Rr42/LED-display-8x11/Hardware/LED-display/LED-display-raytraced-2.png

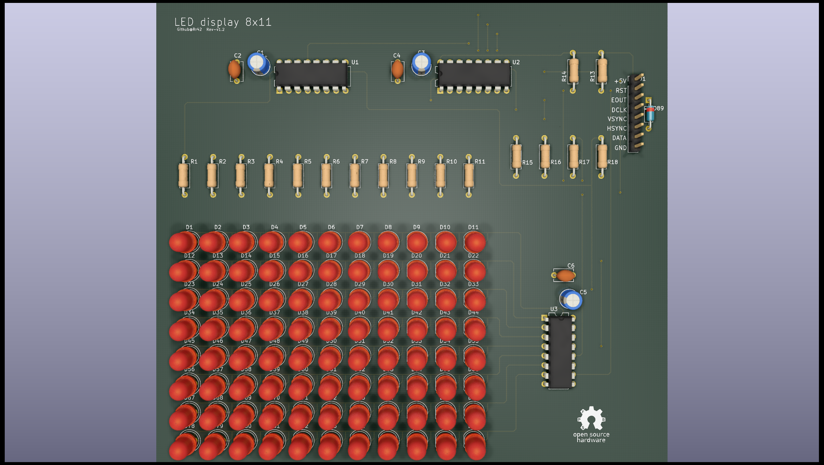
Hardware/LED-display/LED-display-raytraced-2.png
