Rr42/LED-display-8x11/Hardware/LED-display/LED-display.png

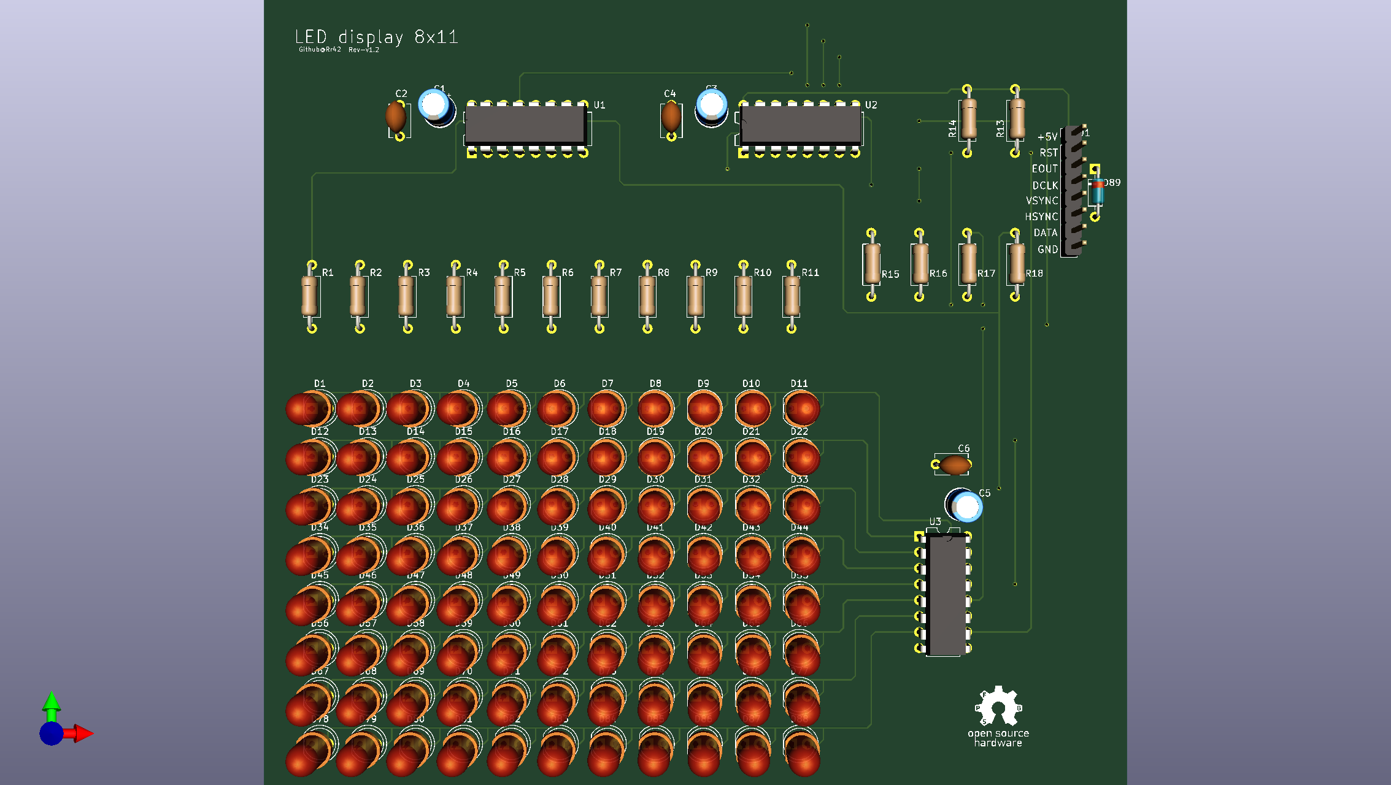
Hardware/LED-display/LED-display.png
