Rr42/LED-display-8x11/LED-display-fab-assimbled.jpg

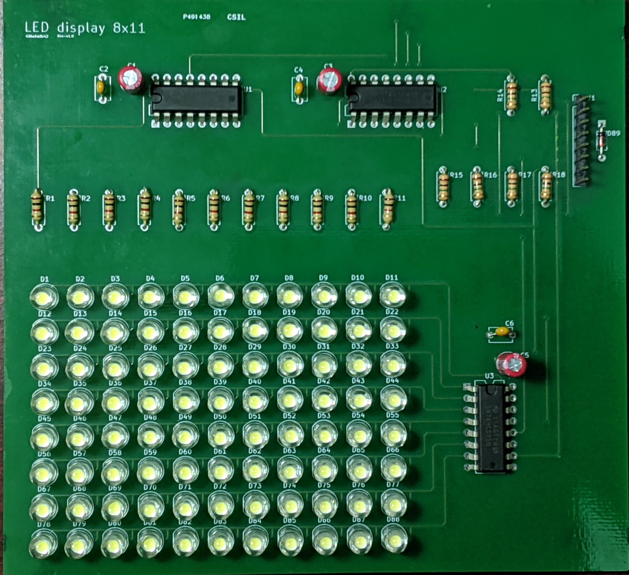
LED-display-fab-assimbled.jpg
