Rr42/LED-display-8x11/LED-display-pattern-1.jpg

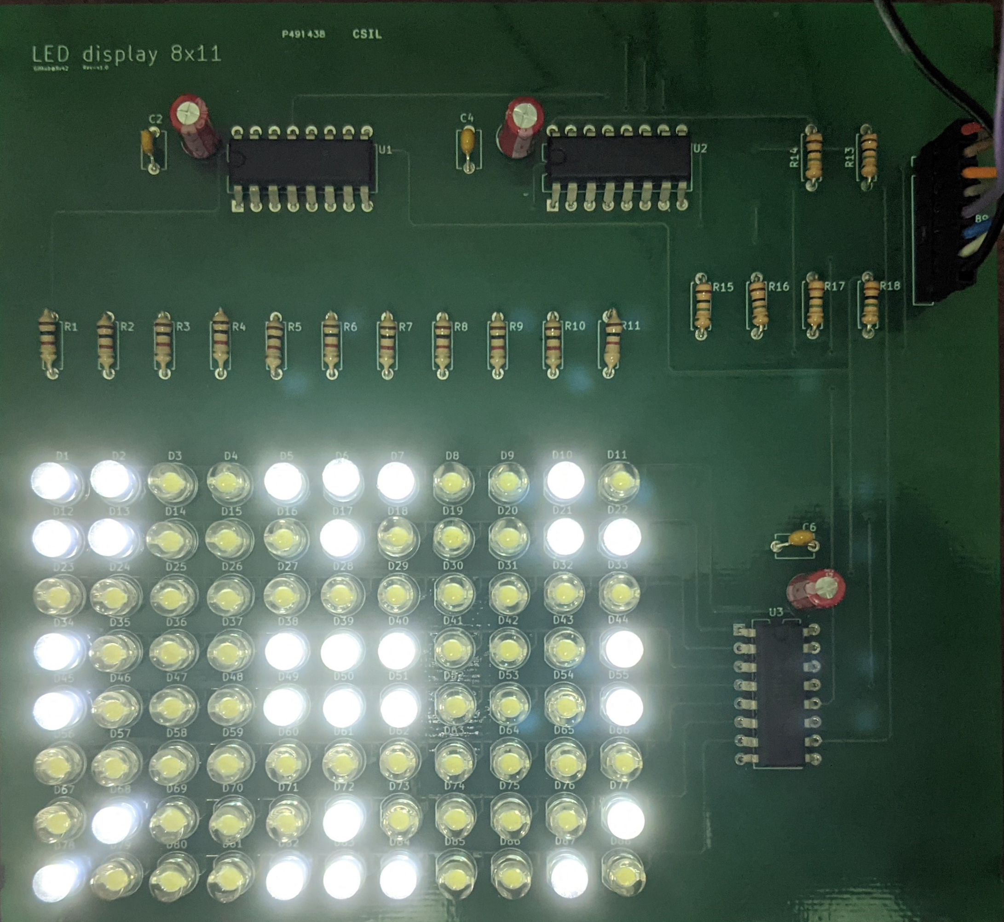
LED-display-pattern-1.jpg
