Rr42/LED-display-8x11/LED-display-pattern-2.jpg

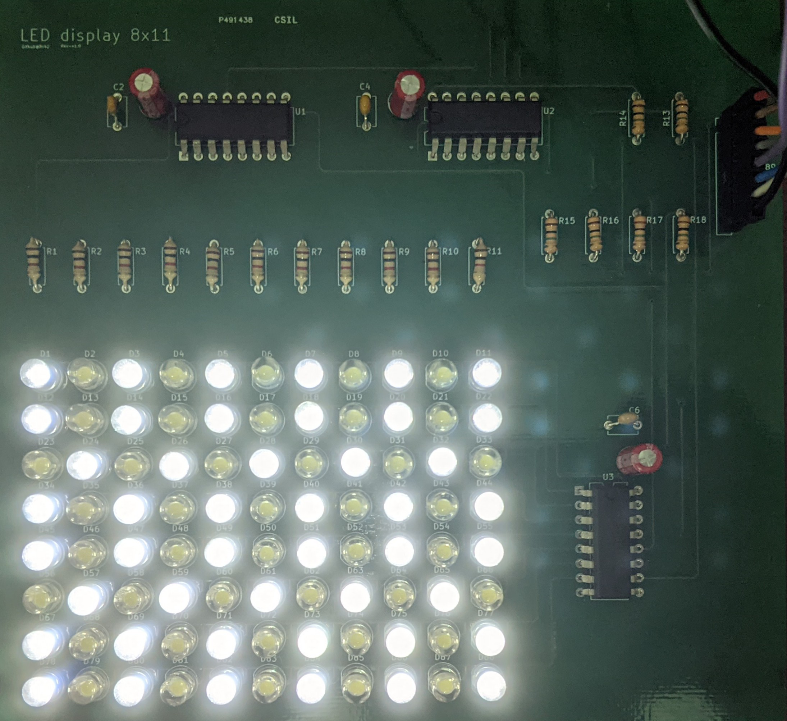
LED-display-pattern-2.jpg
