Rr42/LED-display-8x11/Software/PongBoard/PongBoard.jpg

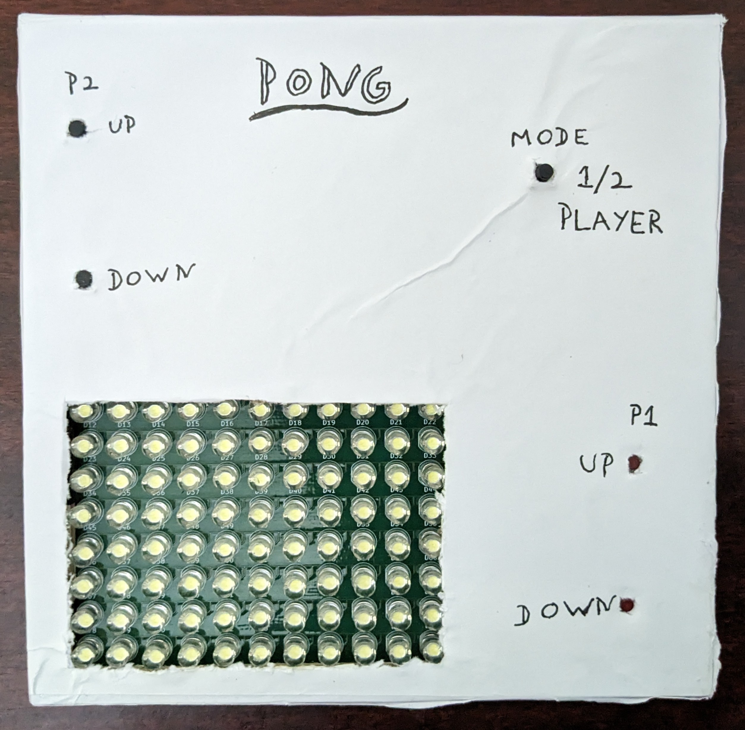
Software/PongBoard/PongBoard.jpg
