Rr42/LED-display-8x11/Hardware/LED-display/LED 8x11 display layout.pdf

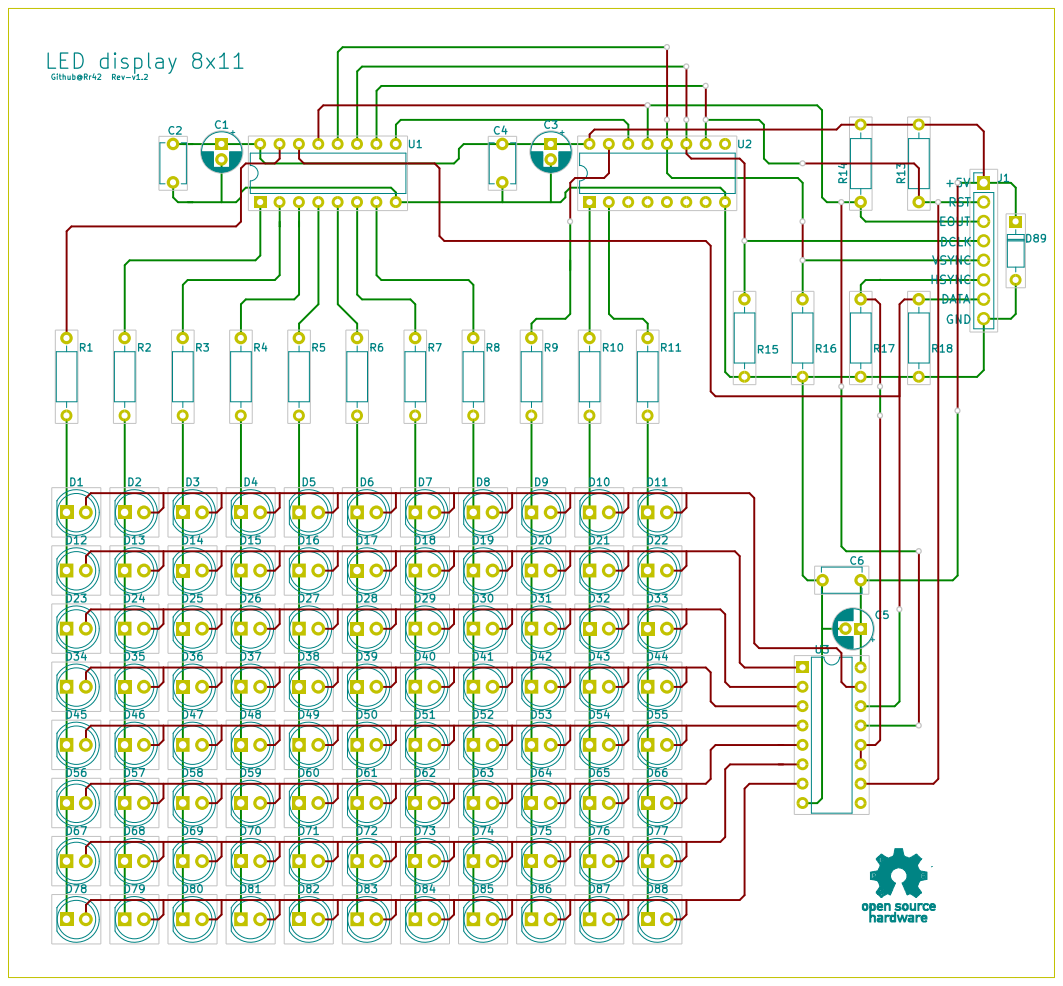
[picture p9: page 1]
