Rr42/LED-display-8x11/Hardware/LED-display/LED 8x11 display schematic BW.pdf

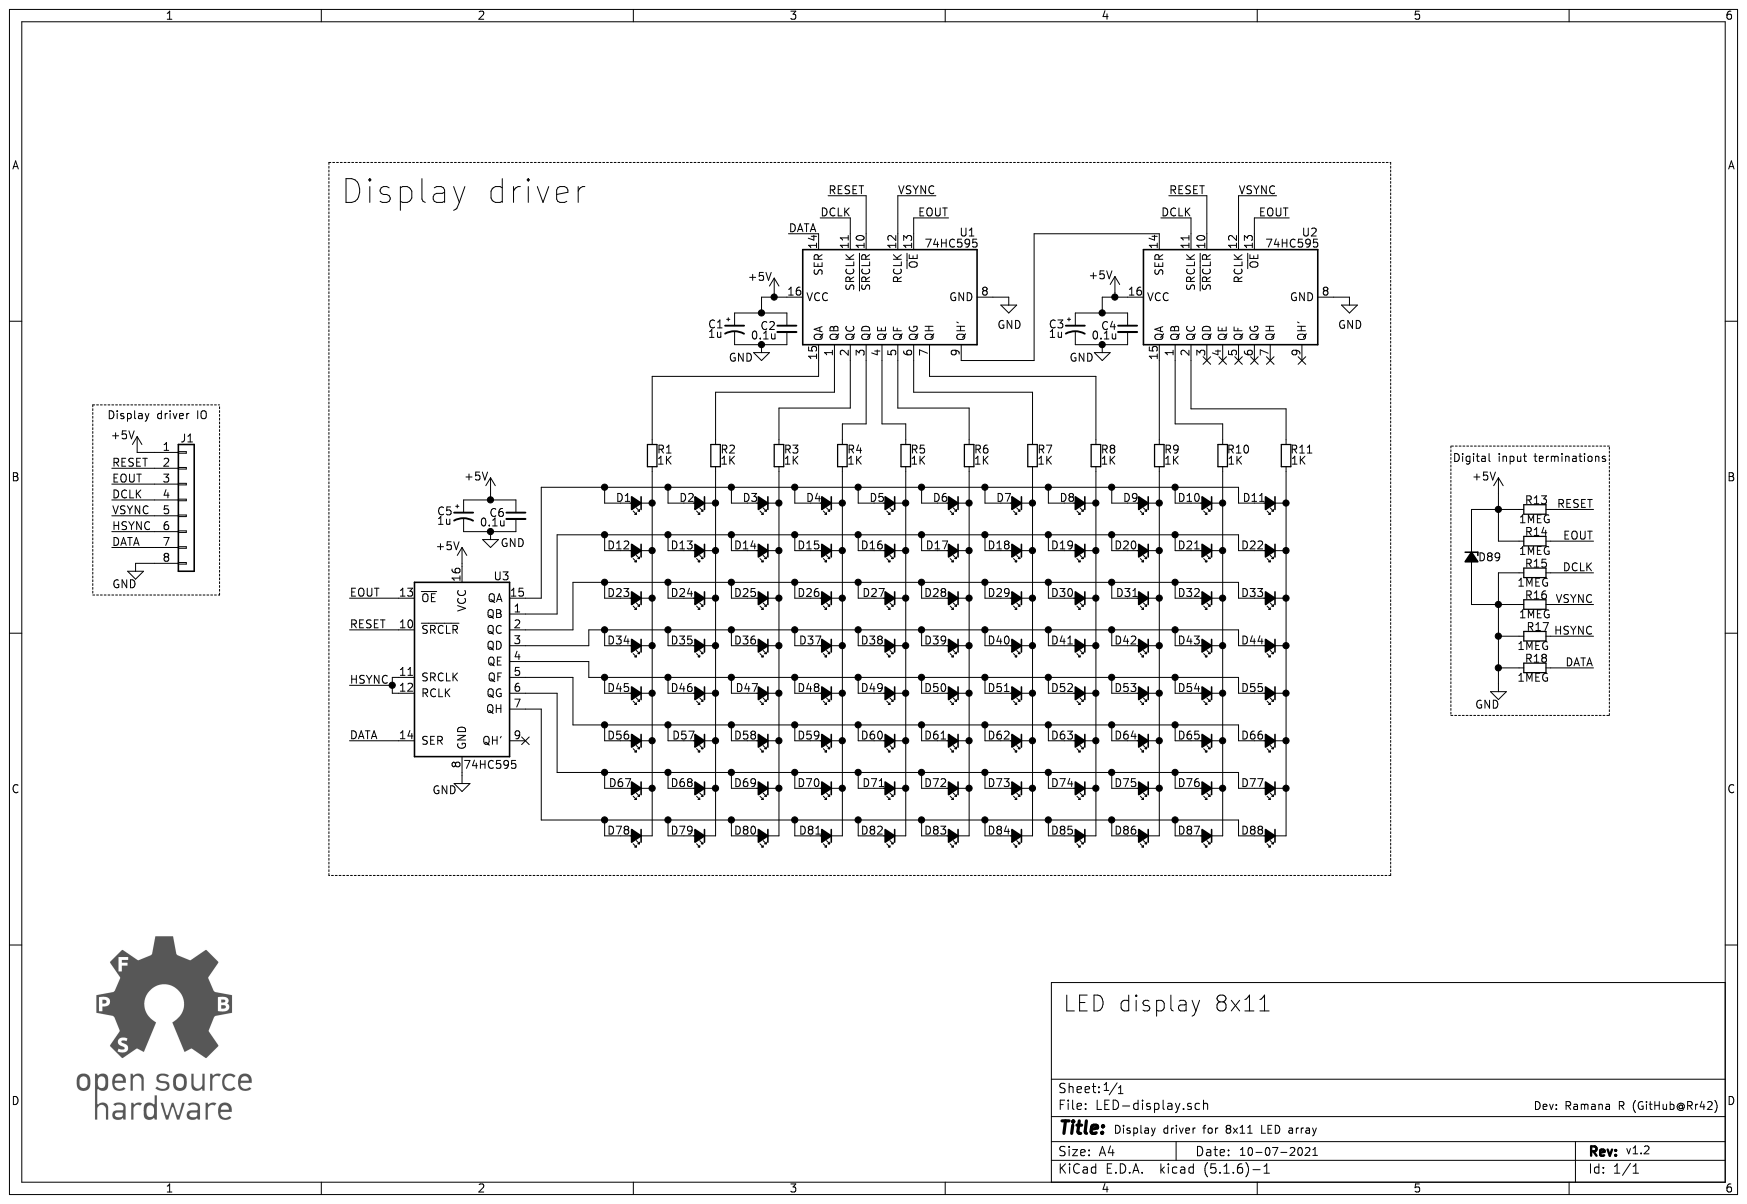
[picture p10: page 1]
