Rr42/LED-display-8x11/Hardware/LED-display/LED 8x11 display schematic.pdf

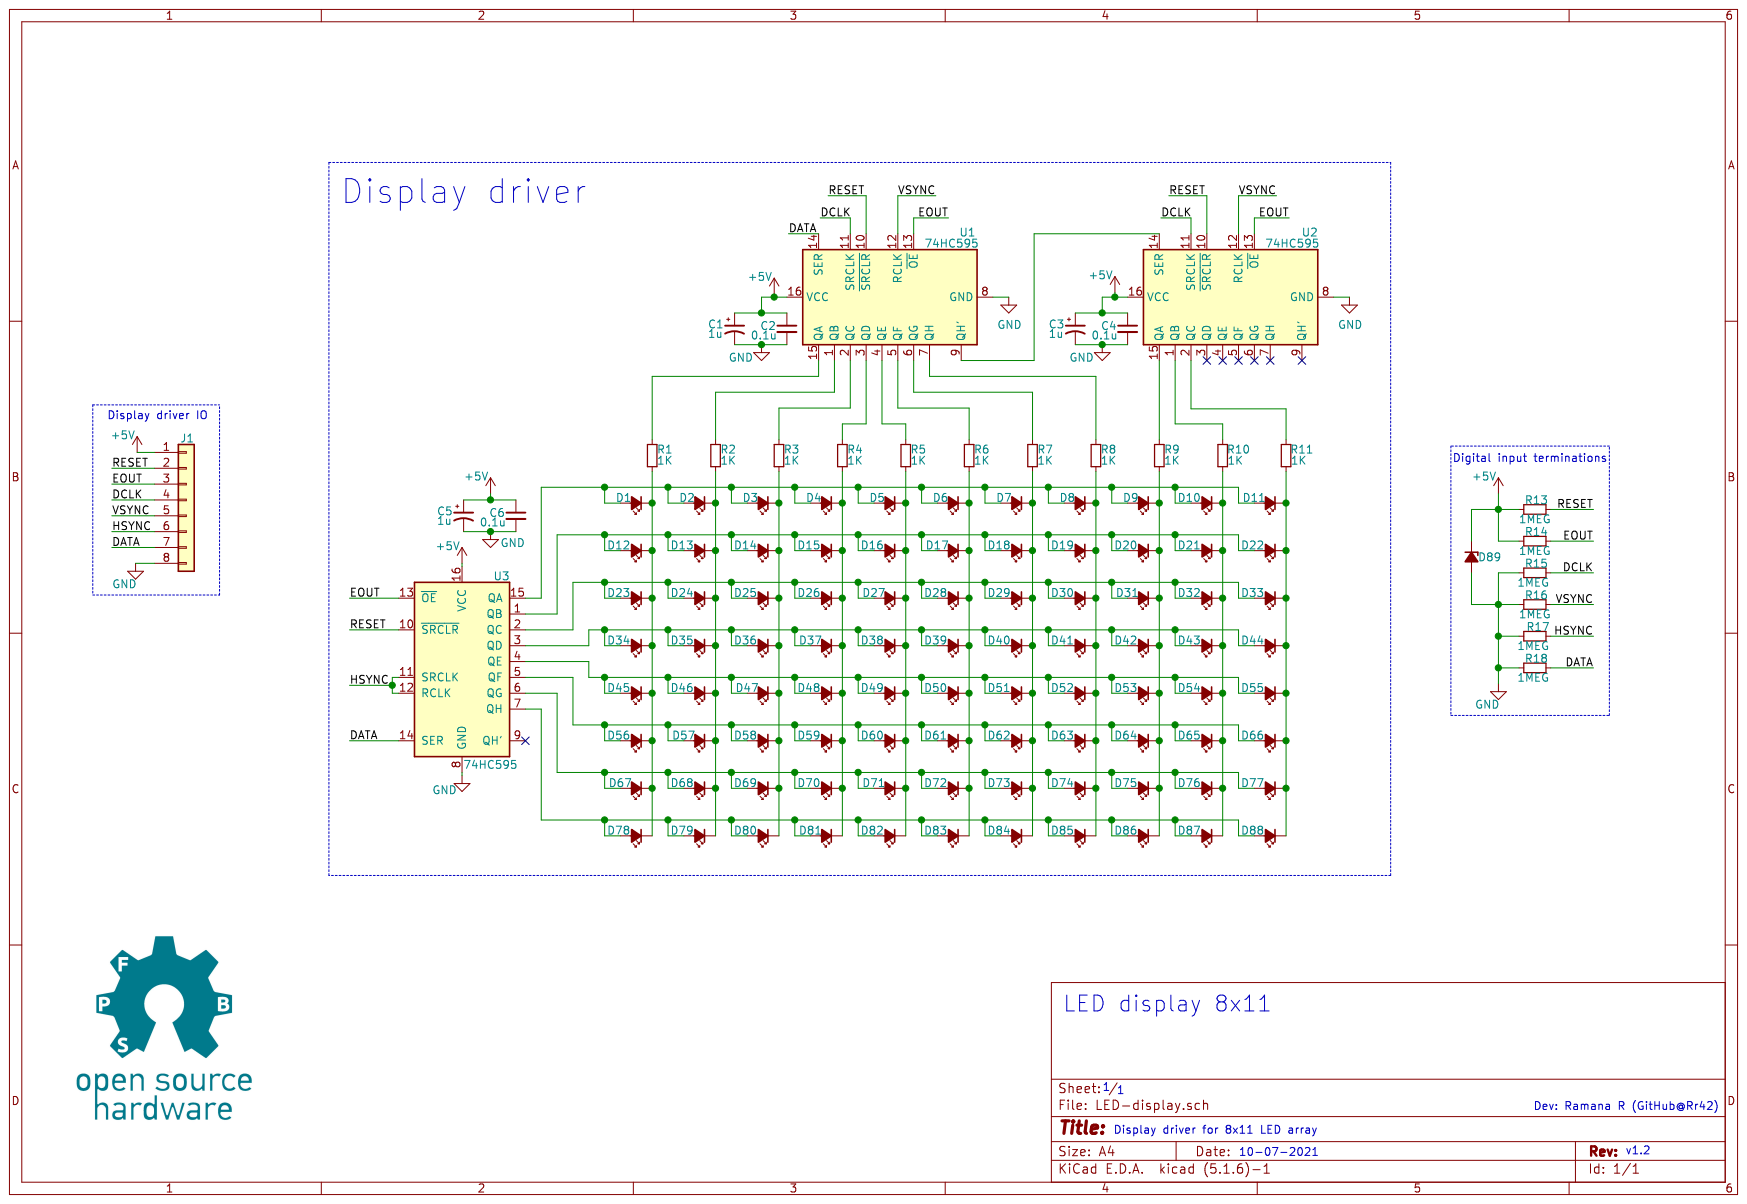
[picture p11: page 1]
