Rr42/LED-display-8x11/Hardware/LED-sim/LED-white-sim.asc

D1: LED
D2: LED
D3: LED
R1: res; 1K
R2: res; 1K
R3: res; 1K
R4: res; 1K
V1: voltage; PWL(0 0 100u 0 150u 5)
V2: voltage; PWL(0 0 50u 0 100u 5 200u 5 210u 0)
V3: voltage; PWL(0 0 50u 0 100u 5 250u 5 260u 0)
V4: voltage; PWL(0 0 50u 0 100u 5 300u 5 310u 0)
Named nets: 0
.tran 500u
