Rr42/LED-display-8x11/Hardware/LED-display/LED-display.kicad_pcb

## KiCad design Hardware/LED-display/LED-display.kicad_pcb (2021-08-29)

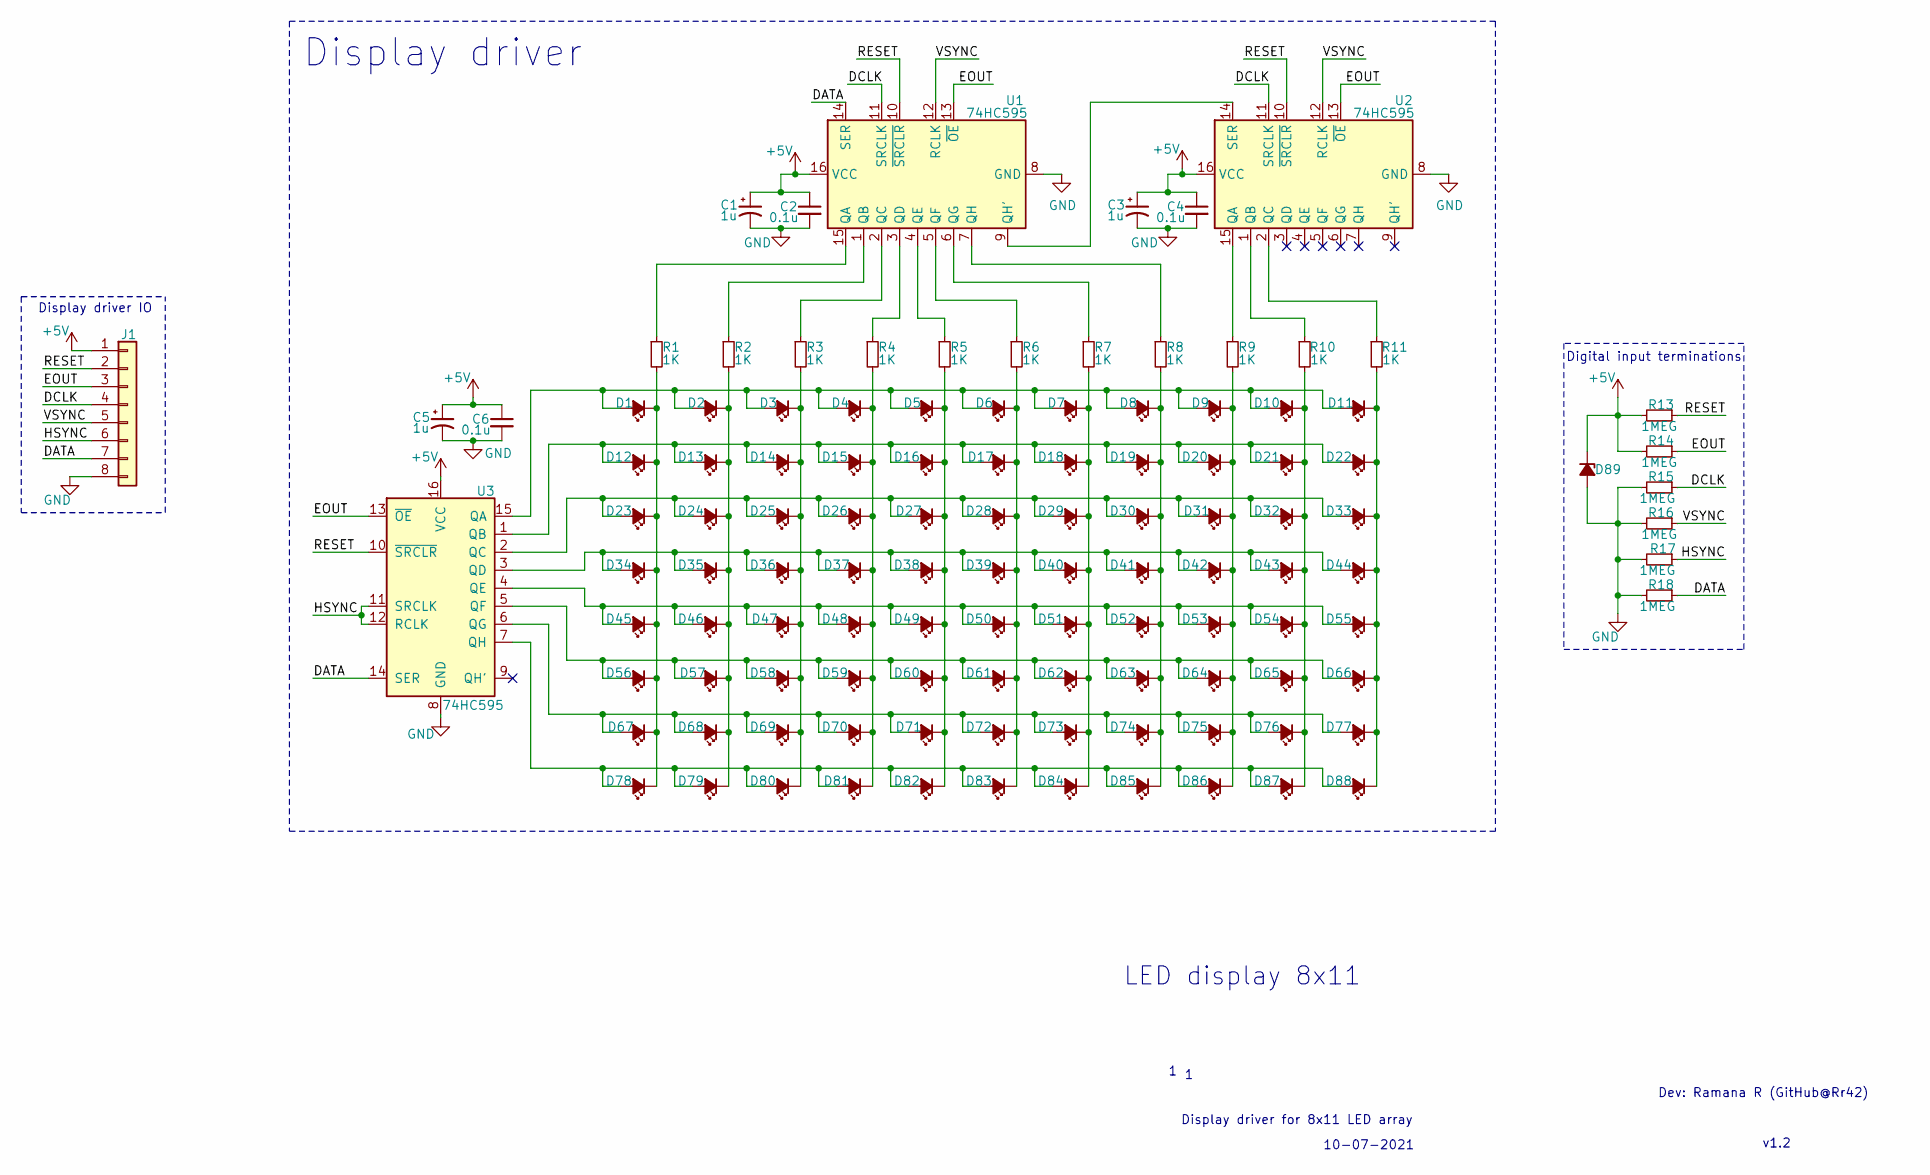
[picture p12: schematic LED-display.sch]

Parts:
C1, C3, C5: 1u; CP_Radial_D5.0mm_P2.00mm
C2, C4, C6: 0.1u; C_Disc_D5.1mm_W3.2mm_P5.00mm
D1, D2, D3, D4, D5, D6, D7, D8, D9, D10, D11, D12, D13, D14, D15, D16, D17, D18, D19, D20, D21, D22, D23, D24, D25, D26, D27, D28, D29, D30, D31, D32, D33, D34, D35, D36, D37, D38, D39, D40, D41, D42, D43, D44, D45, D46, D47, D48, D49, D50, D51, D52, D53, D54, D55, D56, D57, D58, D59, D60, D61, D62, D63, D64, D65, D66, D67, D68, D69, D70, D71, D72, D73, D74, D75, D76, D77, D78, D79, D80, D81, D82, D83, D84, D85, D86, D87, D88: LED_White; LED_D5.0mm
D89: D_Zener_Small_ALT; D_DO-35_SOD27_P7.62mm_Horizontal
J1: Conn_01x08; PinHeader_1x08_P2.54mm_Vertical
R1, R2, R3, R4, R5, R6, R7, R8, R9, R10, R11: 1K; R_Axial_DIN0207_L6.3mm_D2.5mm_P10.16mm_Horizontal
R13, R14, R15, R16, R17, R18: 1MEG; R_Axial_DIN0207_L6.3mm_D2.5mm_P10.16mm_Horizontal
U1, U2, U3: 74HC595; DIP-16_W7.62mm

Connections:
+5V: C1.1, C2.1, C3.1, C4.1, C5.1, C6.1, D89.1 (K), J1.1, R13.2, R14.2, U1.16 (VCC), U2.16 (VCC), U3.16 (VCC)
/DATA: J1.7, R18.1, U1.14 (SER), U3.14 (SER)
/DCLK: J1.4, R15.1, U1.11 (SRCLK), U2.11 (SRCLK)
/EOUT: J1.3, R14.1, U1.13 (~OE), U2.13 (~OE), U3.13 (~OE)
/HSYNC: J1.6, R17.1, U3.11 (SRCLK), U3.12 (RCLK)
/RESET: J1.2, R13.1, U1.10 (~SRCLR), U2.10 (~SRCLR), U3.10 (~SRCLR)
/VSYNC: J1.5, R16.1, U1.12 (RCLK), U2.12 (RCLK)
GND: C1.2, C2.2, C3.2, C4.2, C5.2, C6.2, D89.2 (A), J1.8, R15.2, R16.2, R17.2, R18.2, U1.8 (GND), U2.8 (GND), U3.8 (GND)
unnamed: D1.1 (K), D12.1 (K), D23.1 (K), D34.1 (K), D45.1 (K), D56.1 (K), D67.1 (K), D78.1 (K), R1.2
unnamed: D1.2 (A), D2.2 (A), D3.2 (A), D4.2 (A), D5.2 (A), D6.2 (A), D7.2 (A), D8.2 (A), D9.2 (A), D10.2 (A), D11.2 (A), U3.15 (QA)
unnamed: D10.1 (K), D21.1 (K), D32.1 (K), D43.1 (K), D54.1 (K), D65.1 (K), D76.1 (K), D87.1 (K), R10.2
unnamed: D11.1 (K), D22.1 (K), D33.1 (K), D44.1 (K), D55.1 (K), D66.1 (K), D77.1 (K), D88.1 (K), R11.2
unnamed: D12.2 (A), D13.2 (A), D14.2 (A), D15.2 (A), D16.2 (A), D17.2 (A), D18.2 (A), D19.2 (A), D20.2 (A), D21.2 (A), D22.2 (A), U3.1 (QB)
unnamed: D2.1 (K), D13.1 (K), D24.1 (K), D35.1 (K), D46.1 (K), D57.1 (K), D68.1 (K), D79.1 (K), R2.2
unnamed: D3.1 (K), D14.1 (K), D25.1 (K), D36.1 (K), D47.1 (K), D58.1 (K), D69.1 (K), D80.1 (K), R3.2
unnamed: D4.1 (K), D15.1 (K), D26.1 (K), D37.1 (K), D48.1 (K), D59.1 (K), D70.1 (K), D81.1 (K), R4.2
unnamed: D5.1 (K), D16.1 (K), D27.1 (K), D38.1 (K), D49.1 (K), D60.1 (K), D71.1 (K), D82.1 (K), R5.2
unnamed: D6.1 (K), D17.1 (K), D28.1 (K), D39.1 (K), D50.1 (K), D61.1 (K), D72.1 (K), D83.1 (K), R6.2
unnamed: D7.1 (K), D18.1 (K), D29.1 (K), D40.1 (K), D51.1 (K), D62.1 (K), D73.1 (K), D84.1 (K), R7.2
unnamed: D8.1 (K), D19.1 (K), D30.1 (K), D41.1 (K), D52.1 (K), D63.1 (K), D74.1 (K), D85.1 (K), R8.2
unnamed: D9.1 (K), D20.1 (K), D31.1 (K), D42.1 (K), D53.1 (K), D64.1 (K), D75.1 (K), D86.1 (K), R9.2
unnamed: D23.2 (A), D24.2 (A), D25.2 (A), D26.2 (A), D27.2 (A), D28.2 (A), D29.2 (A), D30.2 (A), D31.2 (A), D32.2 (A), D33.2 (A), U3.2 (QC)
unnamed: D34.2 (A), D35.2 (A), D36.2 (A), D37.2 (A), D38.2 (A), D39.2 (A), D40.2 (A), D41.2 (A), D42.2 (A), D43.2 (A), D44.2 (A), U3.3 (QD)
unnamed: D45.2 (A), D46.2 (A), D47.2 (A), D48.2 (A), D49.2 (A), D50.2 (A), D51.2 (A), D52.2 (A), D53.2 (A), D54.2 (A), D55.2 (A), U3.4 (QE)
unnamed: D56.2 (A), D57.2 (A), D58.2 (A), D59.2 (A), D60.2 (A), D61.2 (A), D62.2 (A), D63.2 (A), D64.2 (A), D65.2 (A), D66.2 (A), U3.5 (QF)
unnamed: D67.2 (A), D68.2 (A), D69.2 (A), D70.2 (A), D71.2 (A), D72.2 (A), D73.2 (A), D74.2 (A), D75.2 (A), D76.2 (A), D77.2 (A), U3.6 (QG)
unnamed: D78.2 (A), D79.2 (A), D80.2 (A), D81.2 (A), D82.2 (A), D83.2 (A), D84.2 (A), D85.2 (A), D86.2 (A), D87.2 (A), D88.2 (A), U3.7 (QH)
unnamed: R1.1, U1.15 (QA)
unnamed: R2.1, U1.1 (QB)
unnamed: R3.1, U1.2 (QC)
unnamed: R4.1, U1.3 (QD)
unnamed: R5.1, U1.4 (QE)
unnamed: R6.1, U1.5 (QF)
unnamed: R7.1, U1.6 (QG)
unnamed: R8.1, U1.7 (QH)
unnamed: R9.1, U2.15 (QA)
unnamed: R10.1, U2.1 (QB)
unnamed: R11.1, U2.2 (QC)
unnamed: U1.9 (QH'), U2.14 (SER)

Notes on the sheet:
10-07-2021
v1.2
Display driver
Display driver IO
Display driver for 8x11 LED array
Dev: Ramana R (GitHub@Rr42)
LED display 8x11
Digital input terminations

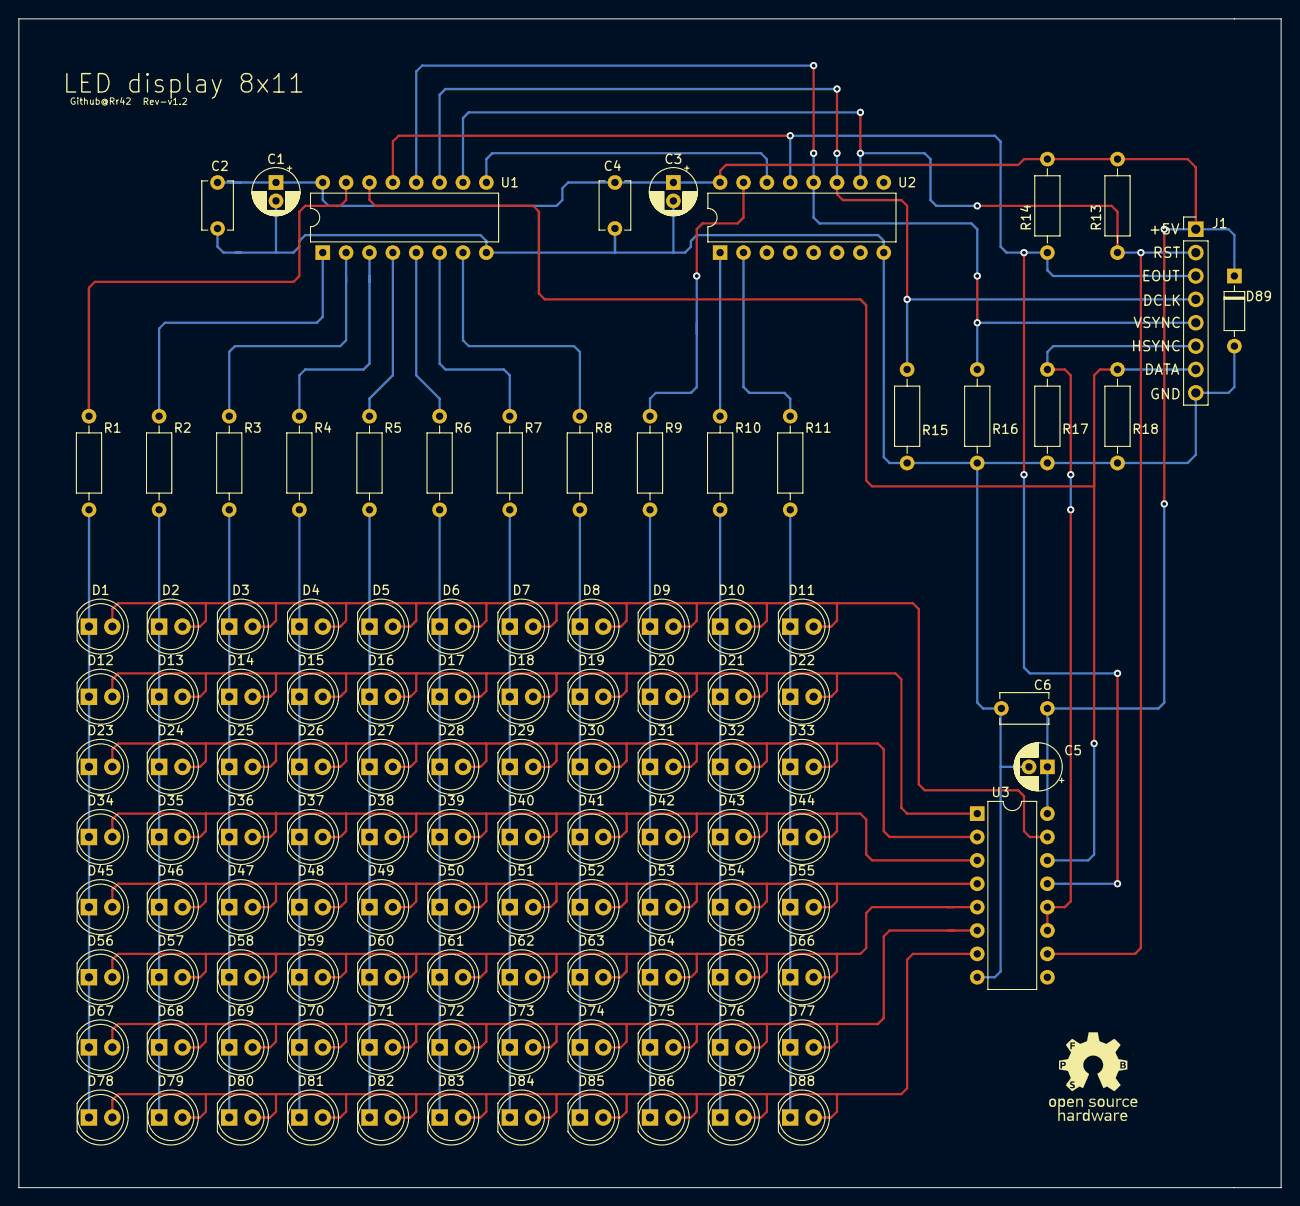
[picture p13: board LED-display.kicad_pcb from above]

Board: 2 copper layers, 137.2 x 127.0 mm, 116 parts (0 on the bottom side), 39 nets.
