Rr42/LED-display-8x11/(commit log)

2021-03-20 First commit > Added KiCAD project files > Added placeholder for Software files
    [LED-display.kicad_pcb, LED-display.sch, Part-list.xlsx]
2021-07-03 Updated layout and reduced number of vias
    [LED-display.kicad_pcb]
2021-07-10 Replaced parllel 2.2K resistors with 1k to match other LEDs
    [LED-display.kicad_pcb, LED-display.sch, Part-list.xlsx]
2021-08-15 Re-adding oshw logo in layout
    [LED-display.kicad_pcb]
2021-08-24 Adding example programs for Arduino > Adding basic driver for Arduino based control > Adding 1 example for switching patterns
2021-08-24 Adding image of fabricated and assembled display
2021-08-24 Updating assembled display image
2021-08-25 Adding support for bit array based frames to allow better storage efficiency
2021-08-25 Adding consolidated display library and example for Arduino
2021-08-26 Rearranging directory structure of Arduino library to match requirements of the Arduino IDE
2021-08-26 Adding bouncy ball example for Arduino
2021-08-26 Updating Arduino example 3 with randomized ball positioning
2021-08-27 Adding pong to Arduino examples
2021-08-29 Updating layout with additional headroom for pins > Updating DIP-16 footprint for easier placement > Updating resistor footprints to allow earier placement > Adding silk for connector pin names
    [LED-display.kicad_pcb, LED-display.sch]
2021-09-07 Patching display flicker when using brightness control. > Adjusting PWM frequency in examples to reduce flicker..
2021-09-11 Adding placeholder Raspberry Pi libraries and examples
2021-09-12 Patching bug where PWM frequency bits where not set properly
    [LED8x11_display_example2.ino, LED8x11_display_example3.ino, LED8x11_display_lib_example.ino]
2023-07-06 Adding firmware for Arduino Nano based pong game board
    * Adding additional examples for Arduino Nano
